mcataford/lukewarmbeer/build/build.md

# Build

Build

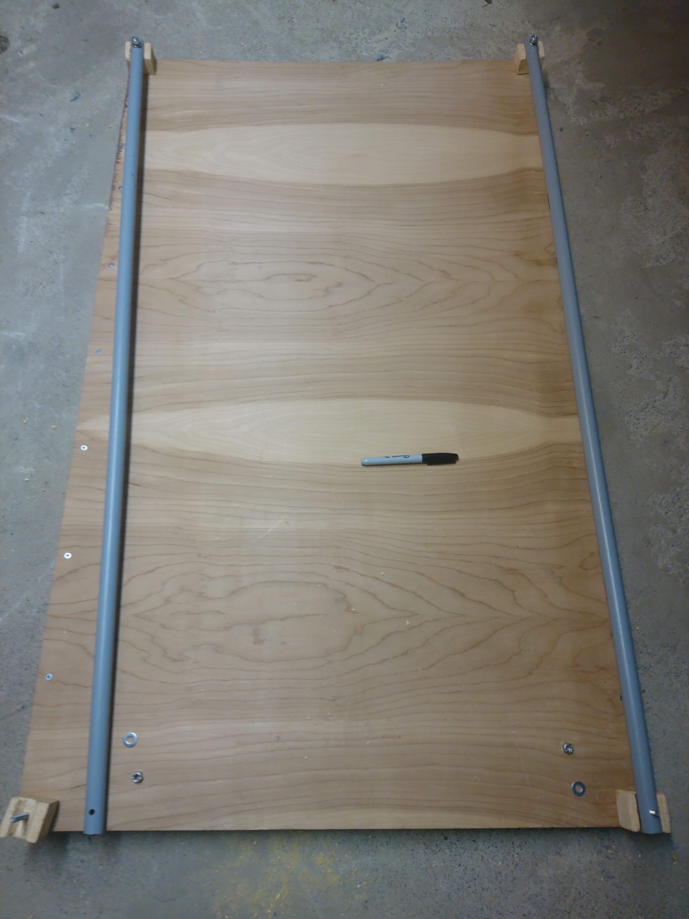
[picture p3: build/1.jpg]
Build

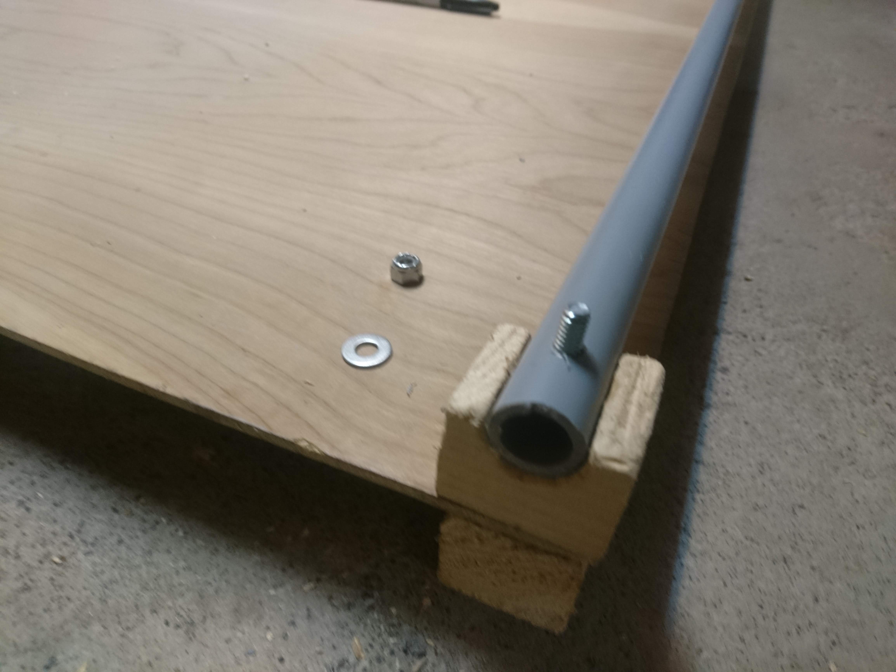
[picture p4: build/2.jpg]
Build

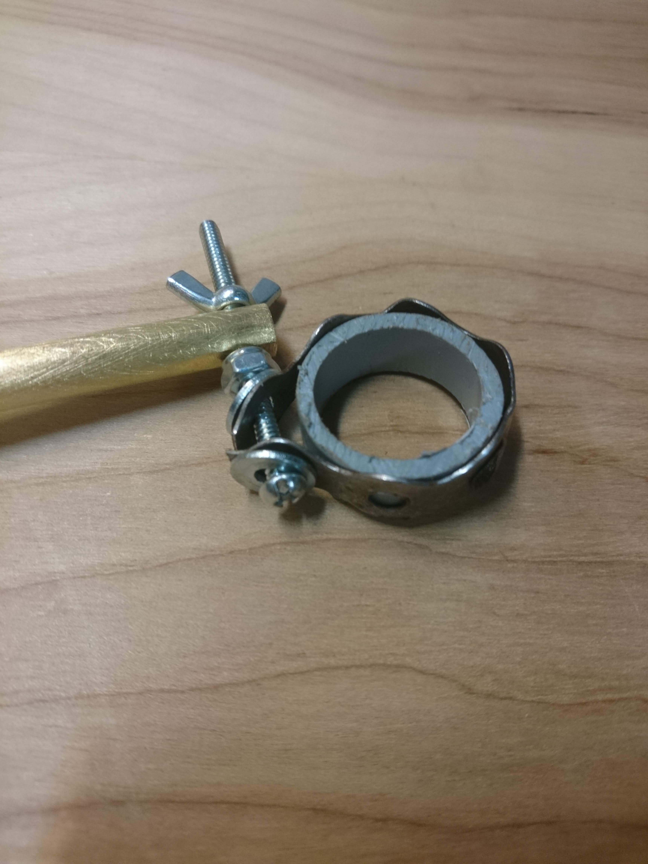
[picture p5: build/3.jpg]
Build

Build
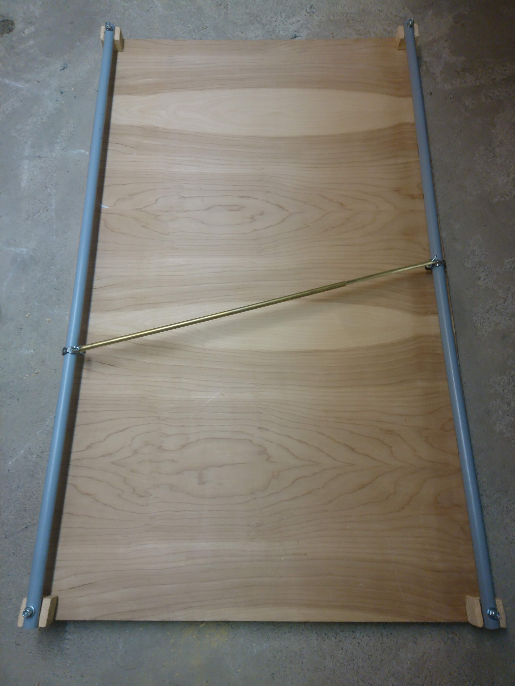
[picture p6: build/4.jpg]
Build

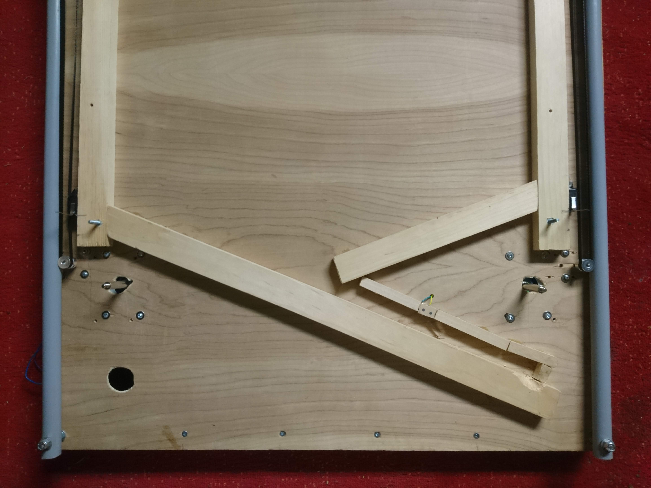
[picture p7: build/5.jpg]
Build

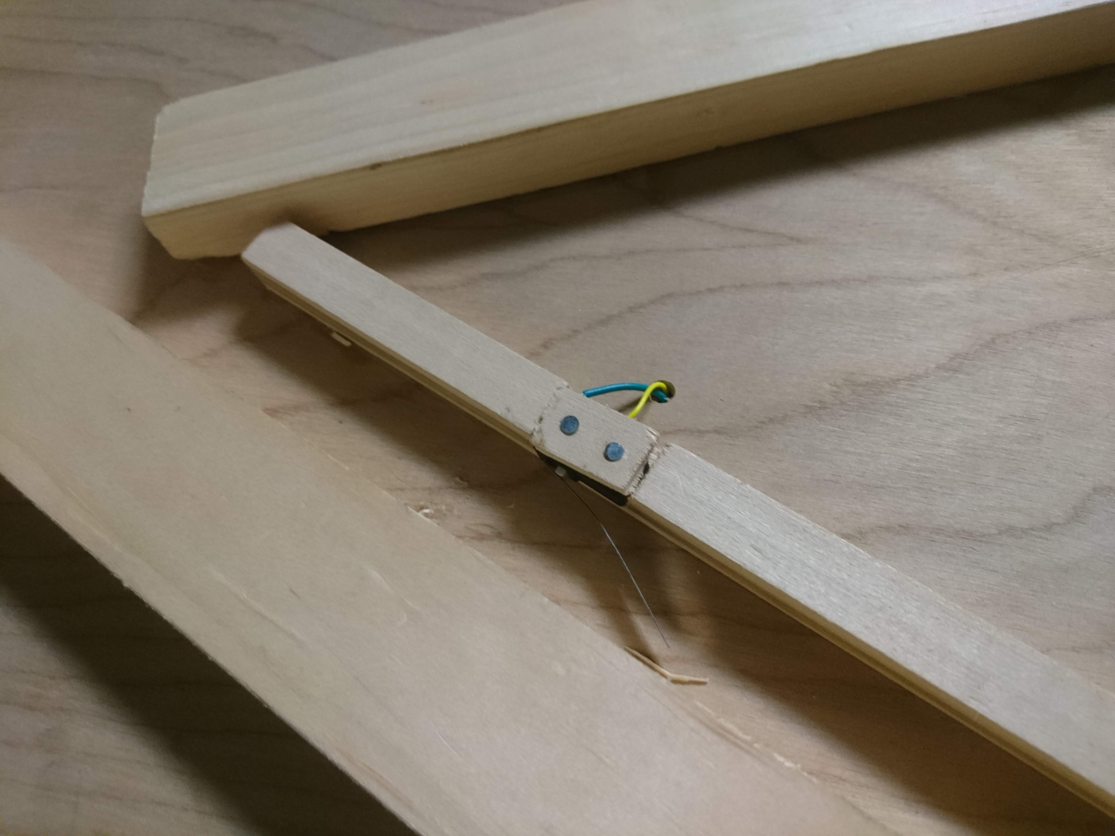
[picture p8: build/6.jpg]
Build

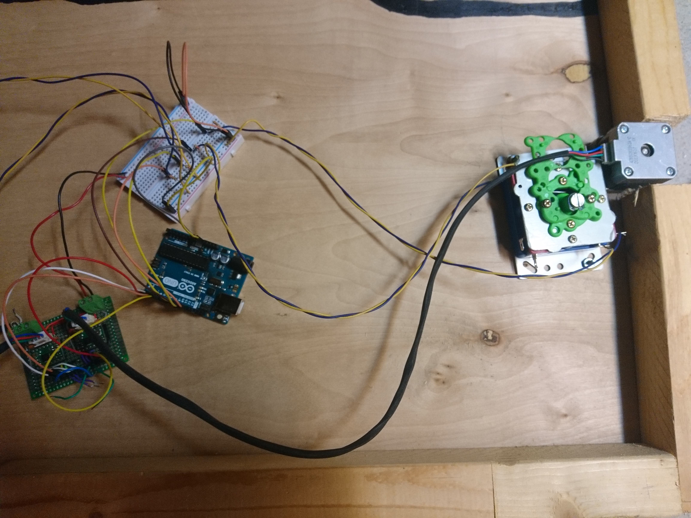
[picture p9: build/7.jpg]
Build

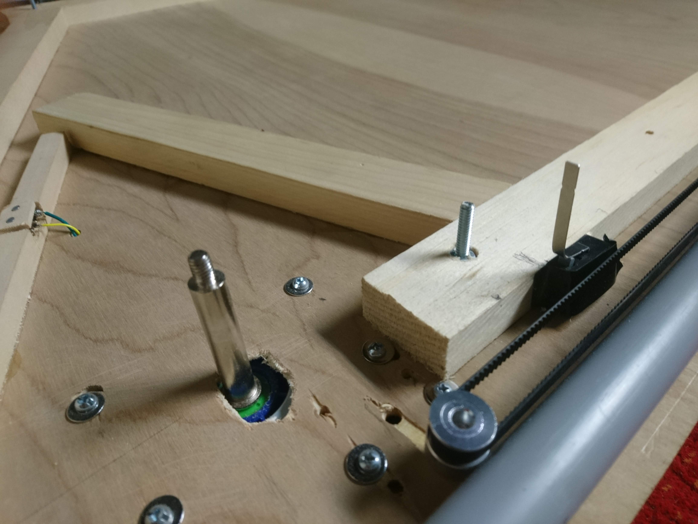
[picture p10: build/8.jpg]
Build
