mcataford/lukewarmbeer/(threads)

Thread 3 (2019-10-11):

Allow adjustable motor speeds

isaacphi, 2019-10-11:
We're using PWM to control the stepper motor STEP signals. With arduino, each PWM pin has a set default frequency so regardless of the duty cycle, motors will spin at the same rate.

Take a look at http://www.righto.com/2009/07/secrets-of-arduino-pwm.html for ways around this. Here's the detailed ATmega datasheet which may also come in handy https://www.sparkfun.com/datasheets/Components/SMD/ATMega328.pdf

isaacphi, 2019-10-13:
https://arduino.stackexchange.com/questions/210/why-do-some-pins-have-a-different-pwm-frequency for a good reference

Closed 2019-10-26.

Thread 5 (2019-10-11):

Implement level over mechanics

isaacphi, 2019-10-11:
Regardless of if you get the ball in the correct hole or not, it will pass by the ball return switch and the bar should level out at the bottom.

- Add switches to confirm that the bar is lowered
- Add ball return switch to confirm that the ball has fallen to the bottom
- Add game logic to reset the game state

Closed 2019-11-27.

Thread 6 (2019-10-11):

Complete circuit

isaacphi, 2019-10-11:
First, spec the number of outputs we need to make sure we have the correct arduino board. Next, build the following circuits:
- arduino shield to house basic circuits and connectors to peripherals
- motor driver (already done)
- individual lights and hole sensors
- LCD displays

Closed 2019-11-27.
