mcataford/lukewarmbeer/(commit log)

2019-08-10 feat: add arduino-cli to bootstrap
2019-08-10 feat: find device task
2019-08-10 wip: add board list command
2019-08-10 wip: switch activated light
2019-08-16 First version of circuit
2019-08-16 update readme with circuit info
2019-09-02 update circuit and parts info
2019-09-02 docs: note re pin protection, potentiometer
2019-09-11 Marc: connect motors with joysticks
2019-09-11 update circuit
2019-10-14 allow setting motor speeds
2019-11-11 get motors working correctly on outputs 9 and 11
    [LukeWarmBeer.ino]
2019-11-13 fix IO pin assignments
    [LukeWarmBeer.ino]
2019-11-27 display, inputs, and motors working
2019-11-27 fix directions and clean a little
    [LukeWarmBeer.ino]
