mcataford/lukewarmbeer/build/0.jpg

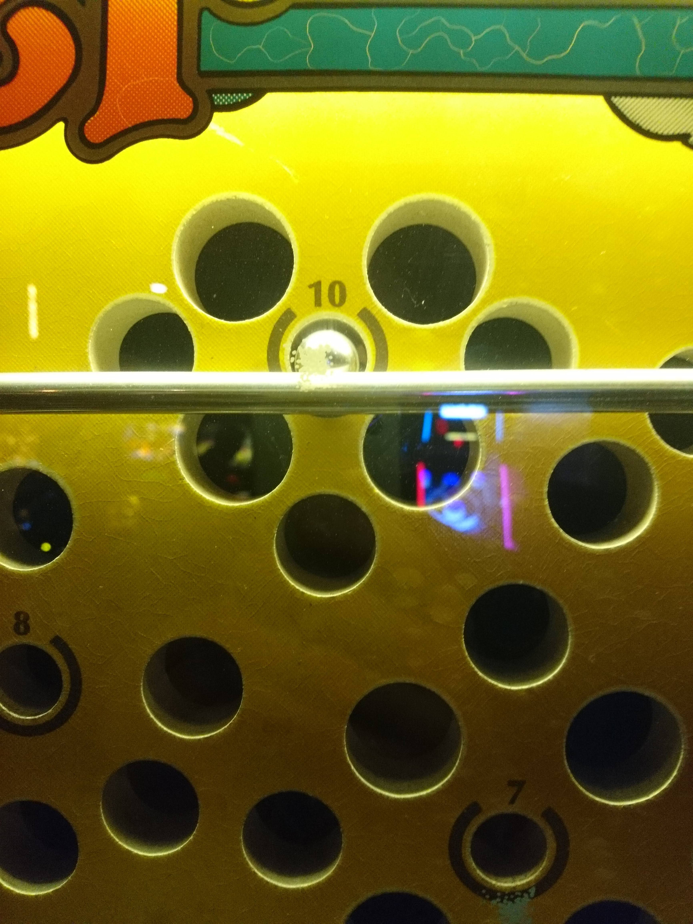
[picture p2: build/0.jpg]
build/0.jpg
